prabpabla/Dynamic-PRSG/DPRSG Fabricated Chip Layout.jpg

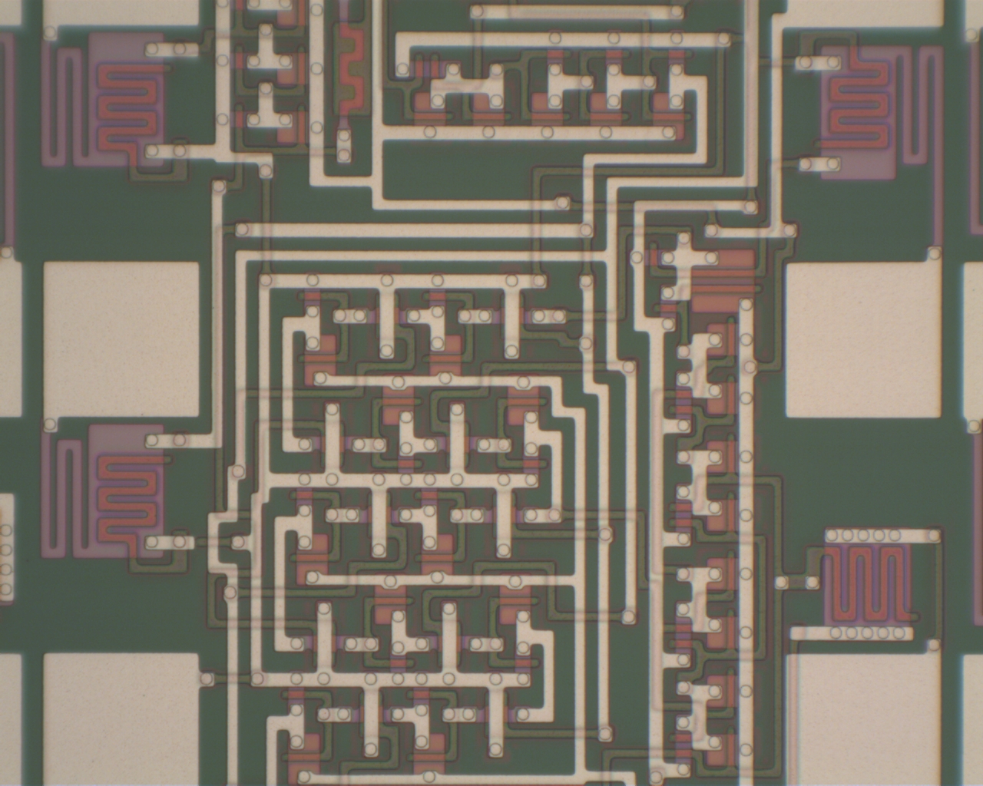
DPRSG Fabricated Chip Layout.jpg
