prabpabla/Dynamic-PRSG/Prober.jpg

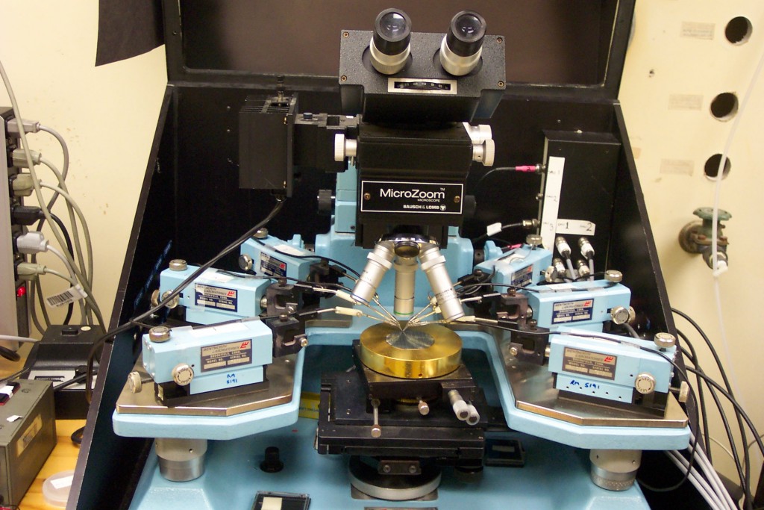
Prober.jpg
