prabpabla/Dynamic-PRSG/Chip being probed Example.jpg

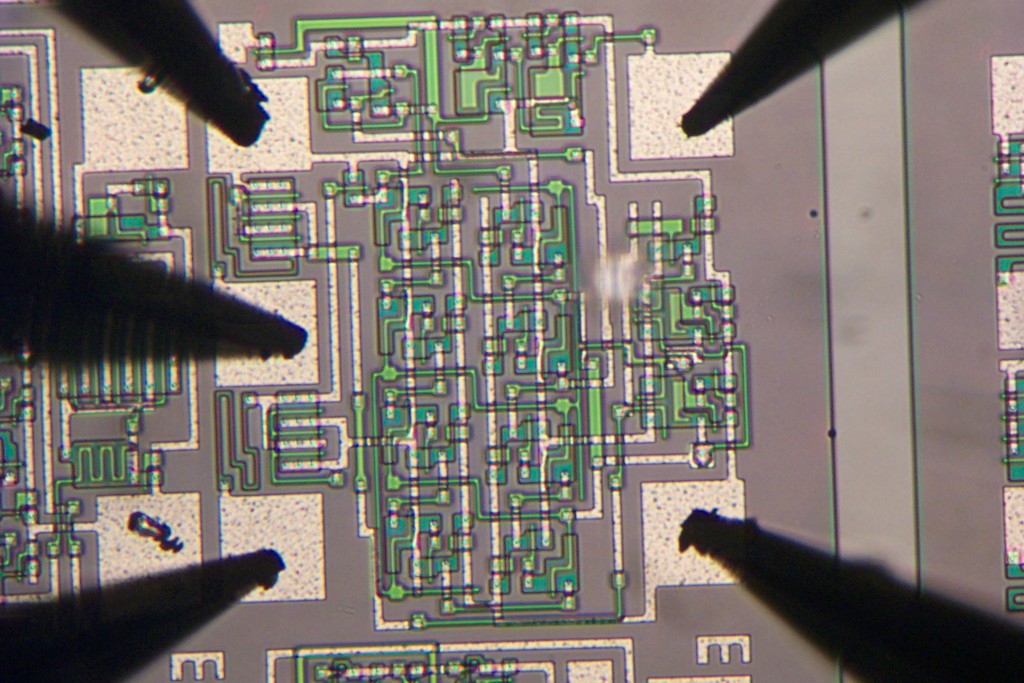
Chip being probed Example.jpg
