prabpabla/Dynamic-PRSG/Final DPRSG Layout.JPG

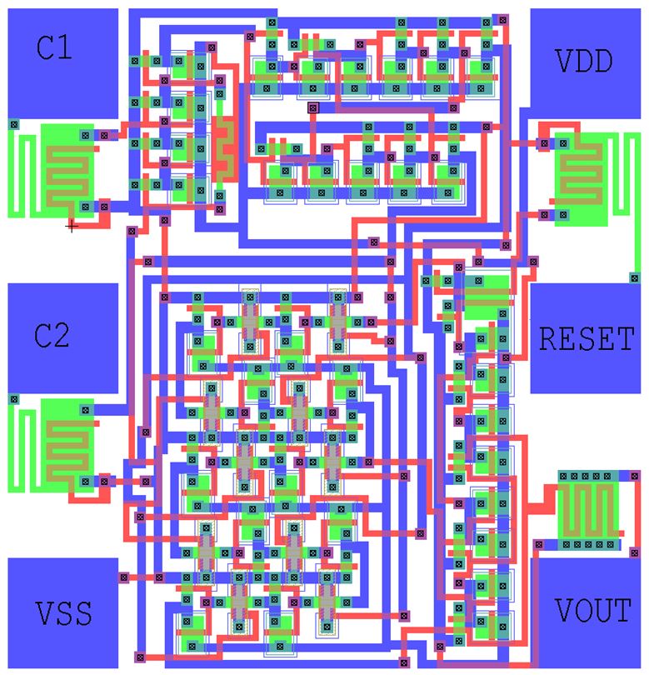
Final DPRSG Layout.JPG
