prabpabla/Dynamic-PRSG/Probes.jpg

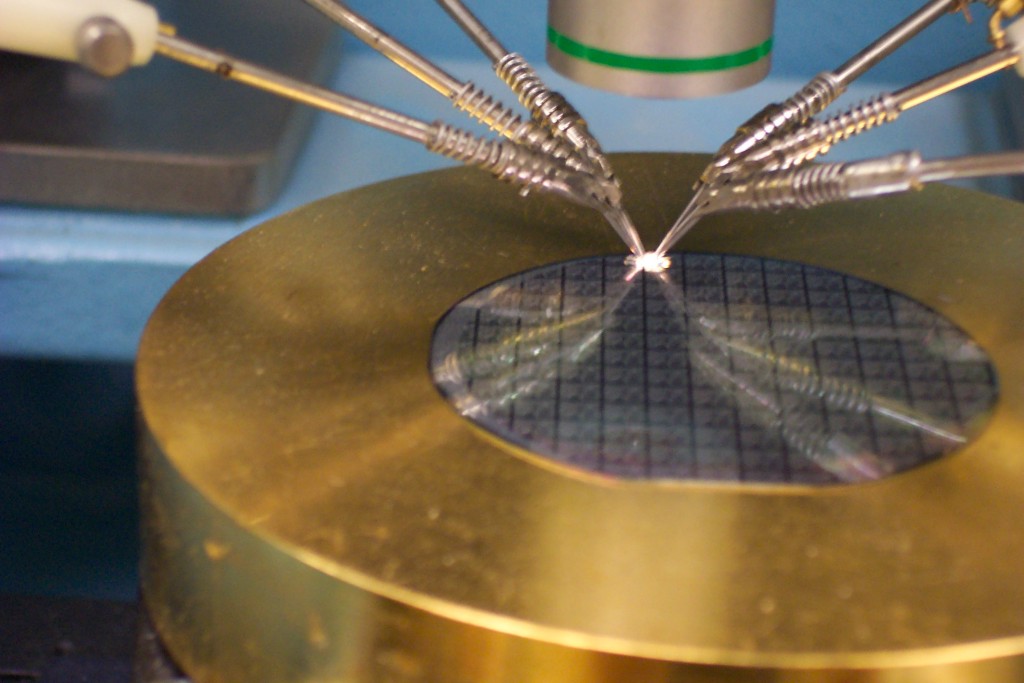
Probes.jpg
