prabpabla/Dynamic-PRSG/PRSG_Dynamic/Top output2.png

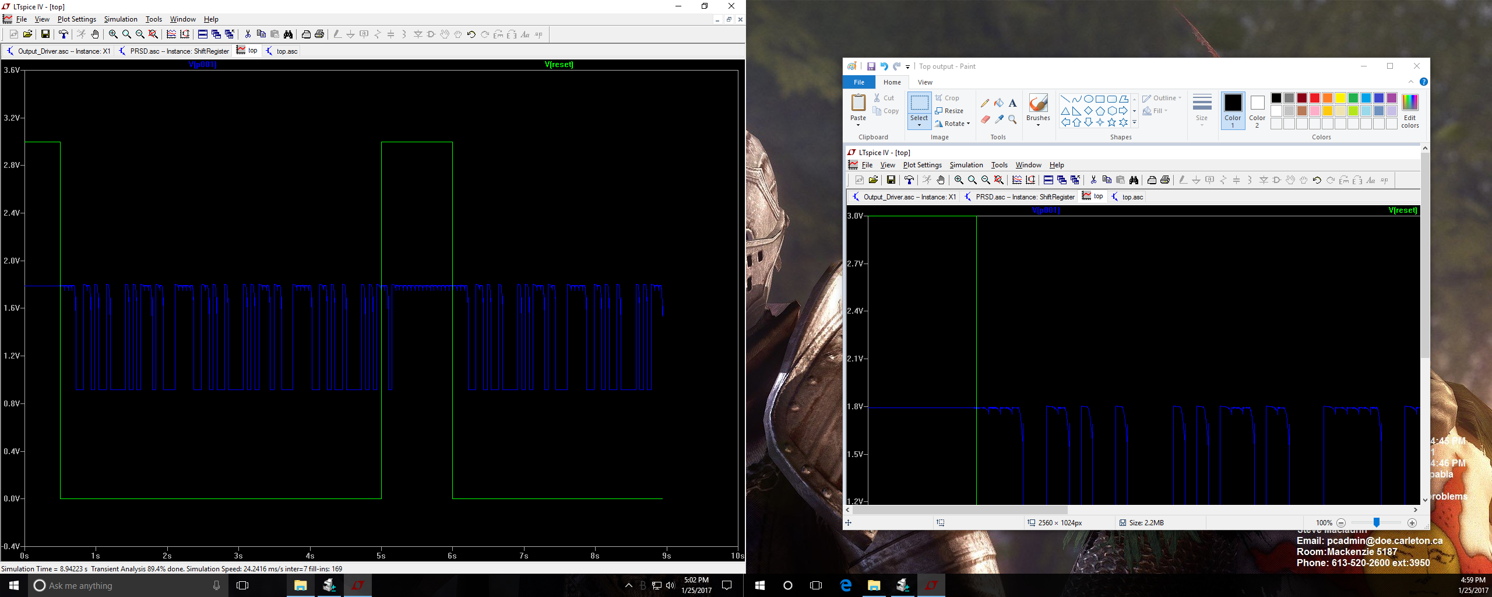
PRSG_Dynamic/Top output2.png
