prabpabla/Dynamic-PRSG/PRSG_Dynamic/Top output.png

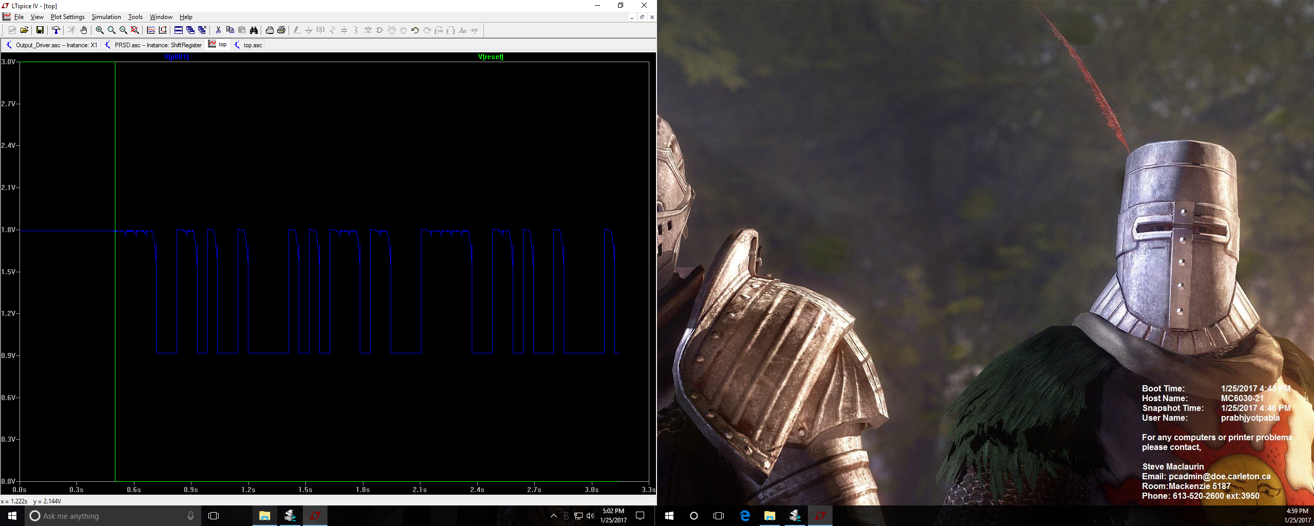
PRSG_Dynamic/Top output.png
