prabpabla/Dynamic-PRSG/PRSG_Dynamic/2phase_CLK_Testbench.asc

V1: voltage; 3
V2: voltage; PULSE(0 3 0 0.1m 0.1m 25m 50m)
X1: 2phase_CLK
Named nets: 0, PHI1, PHI2, PHI
.tran 500m
.Include cmos2017_models.txt
