prabpabla/Dynamic-PRSG/PRSG_Dynamic/Inverter_Testbench.asc

VDD: voltage; 3
VIN: voltage; PULSE(0 3 0 0.1n 0.1n 10n 20n 3)
X1: Invertor_Jan20
Named nets: 0, VOUT, VDD, VIN
;dc VIN 0 3 0.01
.include cmos2017_models.txt
.tran 0 40n 0 0.1n
