prabpabla/Dynamic-PRSG/PRSG_Dynamic/Master_CLK_Testbench.asc

C1: cap; 100n
VDD: voltage; 3
X1: Master_CLK
Named nets: 0, PHI, C1, C2
.tran 500m
.include cmos2017_models.txt
