prabpabla/Dynamic-PRSG/PRSG_Dynamic/Output_Driver_2_LVS_TEST.asc

M1: nmos4; l=4.8u w=256.8u
M2: nmos4; l=4.8u w=242.4u
M3: nmos4; l=4.8u w=242.4u
M4: nmos4; l=4.8u w=242.4u
ShiftRegister: PRSD
Named nets: VSS, RESET, VDD, LED, VOUT, C1, C2
.Include cmos2017_models.txt
