prabpabla/Dynamic-PRSG/PRSG_Dynamic/Output_Driver_Testbench.asc

C1: cap; 15n
D1: diode; Di_LED
M1: nmos4; l=9.6u w=200u
ShiftRegister: PRSD
V1: voltage; 3
V2: voltage; PULSE(0 3 1m 1p 1p 5m 400m 2)
Named nets: 0, RESET
.tran 1
.include cmos2017_models.txt
.model Di_LED D (IS=4e-20 RS=0 BV=5 IBV=100u CJO=0 M=0.5 N=2)
