prabpabla/Dynamic-PRSG/PRSG_Dynamic/PRSD_Testbench.asc

2PhaseCLK: 2phase_CLK
C1: cap; 15n
MasterCLK: Master_CLK
V1: voltage; 3
V2: voltage; PULSE(0 3 0 1p 1p 100m 400m 2)
X1: Shift_Register
X2: Shift_Register
X3: Shift_Register
X4: Shift_Register
X5: Shift_Register
XNOR: XNOR_Reset
Named nets: PHI1, PHI2, VOUT, 0, VDD, VSS, RESET
.tran 1
.include cmos2017_models.txt
