prabpabla/Dynamic-PRSG/PRSG_Dynamic/Shift_Register_CLK_Testbench.asc

V1: voltage; 3
V2: voltage; PULSE(0 3 0 0.1n 0.1n 1m 2m)
V3: voltage; PULSE(0 3 0 0.1n 0.1n 10m 20m)
X1: 2phase_CLK
X2: Shift_Register
Named nets: 0, PHI1, PHI2, PHI, Q, D
.tran 500m
.Include cmos2017_models.txt
