prabpabla/Dynamic-PRSG/PRSG_Dynamic/Shift_Register_Testbench.asc

V1: voltage
V2: voltage
X1: Shift_Register
.include cmos2017_models.txt
