prabpabla/Dynamic-PRSG/PRSG_Dynamic/XNOR_Reset_Testbench.asc

A: voltage; PULSE(0 3 0 1n 1n 10m 20m 10)
B: voltage; PULSE(0 3 0 1n 1n 5m 10m 20)
RESET: voltage; PULSE(0 3 0 1n 1n 50m 100m)
VDD: voltage; 3
X1: XNOR_Reset
Named nets: 0, VOUT
.tran 500m
.include cmos2017_models.txt
