prabpabla/Dynamic-PRSG/PRSG_Dynamic/2phase_CLK.asc

X1: Invertor_Jan20
X2: nand
X3: nand
X4: Invertor_Jan20
X5: Invertor_Jan20
X6: Invertor_Jan20
X7: Invertor_Jan20
X8: Invertor_Jan20
X9: Invertor_Jan20
Named nets: VDD, VSS, PHI, PHI1, PHI2
