prabpabla/Dynamic-PRSG/PRSG_Dynamic/Final_PRSG.asc

C1: cap; 100n
D1: diode; Di_LED
V1: voltage; 3
V2: voltage; PULSE(0 3 5m 1p 1p 20m 400m 2)
X1: Output_Driver
Named nets: 0
.include cmos2017_models.txt
.model Di_LED D (IS=4e-20 RS=0 BV=5 IBV=100u CJO=0 M=0.5 N=2)
.options plotwinsize=0
.tran 10
