prabpabla/Dynamic-PRSG/PRSG_Dynamic/FOUR_NAND.asc

X1: nand
X2: nand
X3: nand
X4: nand
Named nets: VDD, A, B, VOUT, VSS
