prabpabla/Dynamic-PRSG/PRSG_Dynamic/Invertor_Jan20.asc

M1: pmos4; l=4.8u w=19.2u
M2: nmos4; l=4.8u w=9.6u
Named nets: VIN, VOUT, VDD, VSS
