prabpabla/Dynamic-PRSG/PRSG_Dynamic/Master_CLK.asc

M1: nmos4; l=96u w=4.8u
X1: Invertor_Jan20
X2: Invertor_Jan20
X3: Invertor_Jan20
X4: Invertor_Jan20
Named nets: VDD, C2, VSS, C1, PHI
