prabpabla/Dynamic-PRSG/PRSG_Dynamic/nand.asc

M1: pmos4; l=4.8u w=19.2u
M2: pmos4; l=4.8u w=19.2u
M3: nmos4; l=4.8u w=9.6u
M4: nmos4; l=4.8u w=9.6u
Named nets: VSS, A, B, VDD, VOUT
