prabpabla/Dynamic-PRSG/PRSG_Dynamic/nor.asc

M1: pmos4; l=4.8u w=38.4u
M2: pmos4; l=4.8u w=38.4u
M3: nmos4; l=4.8u w=9.6u
M4: nmos4; l=4.8u w=9.6u
Named nets: A, B, VDD, VOUT, VSS
