prabpabla/Dynamic-PRSG/PRSG_Dynamic/Output_Driver.asc

M1: nmos4; l=4.8u w=256.8u
ShiftRegister: PRSD
Named nets: C1, C2, RESET, VDD, VSS, LED
.Include cmos2017_models.txt
