prabpabla/Dynamic-PRSG/PRSG_Dynamic/PRSD.asc

2PhaseCLK: 2phase_CLK
MasterCLK: Master_CLK
X1: Shift_Register
X2: Shift_Register
X3: Shift_Register
X4: Shift_Register
X5: Shift_Register
XNOR: XNOR_Reset
Named nets: PHI1, PHI2, VDD, VSS, RESET, VOUT, C1, C2
.Include cmos2017_models.txt
