prabpabla/Dynamic-PRSG/PRSG_Dynamic/Shift_Register.asc

M1: pmos4; l=4.8u w=19.2u
M2: pmos4; l=4.8u w=19.2u
M3: nmos4; l=4.8u w=9.6u
M4: nmos4; l=16.8u w=9.6u
M5: nmos4; l=4.8u w=9.6u
M6: nmos4; l=16.8u w=9.6u
Named nets: PHI1, PHI2, D, VDD, VSS, Q
