prabpabla/Dynamic-PRSG/PRSG_Dynamic/top.asc

Cext: cap; 100n
D1: diode; Di_LED
V1: voltage; 3
V2: voltage; PULSE(0 3 5 1u 1u 1 100 1)
V3: voltage; PULSE(3 0 0.5 1u 1u 99 100 1)
X1: Output_Driver
Named nets: 0
.model Di_LED D (IS=4e-20 RS=0 BV=5 IBV=100u CJO=0 M=0.5 N=2)
.include cmos2017_models.txt
.tran 5
