prabpabla/Dynamic-PRSG/PRSG_Dynamic/XNOR_Reset.asc

X1: nand
X2: nand
X3: nand
X4: nand
X5: nor
Named nets: VDD, A, B, RESET, VOUT, VSS
